blind-oracle/zvv-schedule-display/wall_bracket.stl

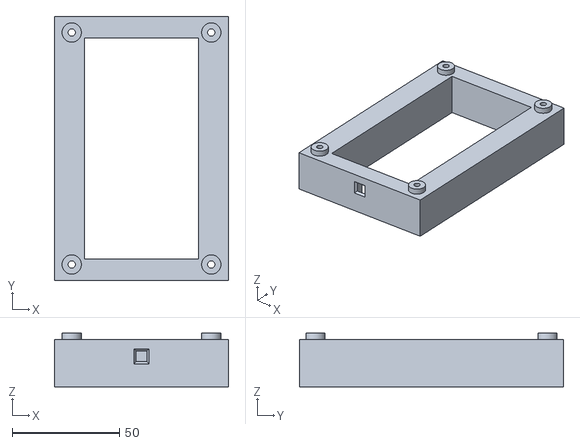
[picture p2: CAD file, 2026-11-14]
wall_bracket.stl
81.0 x 123.0 x 25.0
