blind-oracle/zvv-schedule-display/(commit log)

2026-11-14 Add directio filter
2026-11-14 Add image, bracket STL, update readme.
    [wall_bracket.stl]
